adisoman/syklops-nova/README.md

# syklops-nova
Syklops nova is a series of beginner friendly I2C extender boards for GPIOs. It makes complex multi-component work possible, even for MCUs with fewer GPIOs.
