adisoman/syklops-nova/syklops1.kicad_pcb

## KiCad design syklops1.kicad_pcb (2026-01-10)

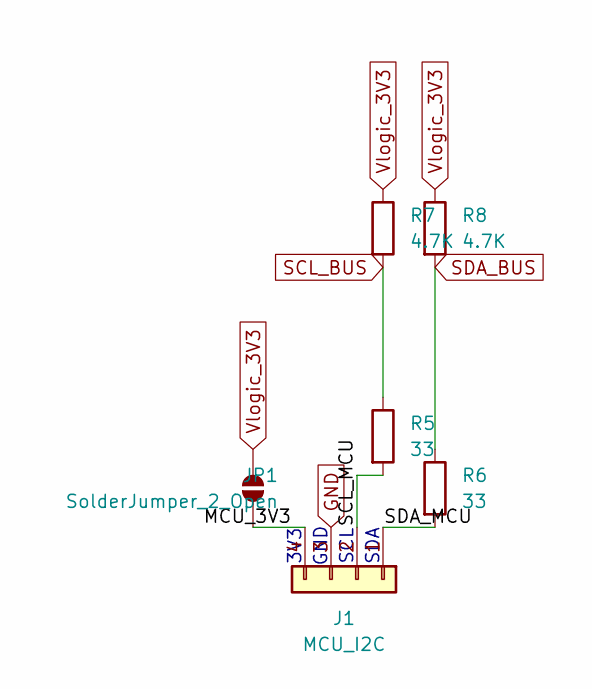
[picture p1: schematic mcu_interface.kicad_sch]

Parts:
J1: MCU_I2C; PinSocket_1x04_P2.54mm_Vertical; LCSC C5116530
JP1: SolderJumper_2_Open; SolderJumper-2_P1.3mm_Open_RoundedPad1.0x1.5mm
R5, R6: 33; R_0805_2012Metric; LCSC C17634
R7, R8: 4.7K; R_0805_2012Metric; LCSC C17673

Connections:
/MCU_interface/MCU_3V3: J1.4, JP1.1 (A)
/MCU_interface/SCL_MCU: J1.2, R5.2
/MCU_interface/SDA_MCU: J1.1, R6.2
GND: J1.3; also elsewhere on the board
SCL_BUS: R5.1, R7.2; also elsewhere on the board
SDA_BUS: R6.1, R8.2; also elsewhere on the board
Vlogic_3V3: JP1.2 (B), R7.1, R8.1; also elsewhere on the board

Notes on the sheet:
SDA
SCL
3V3
GND

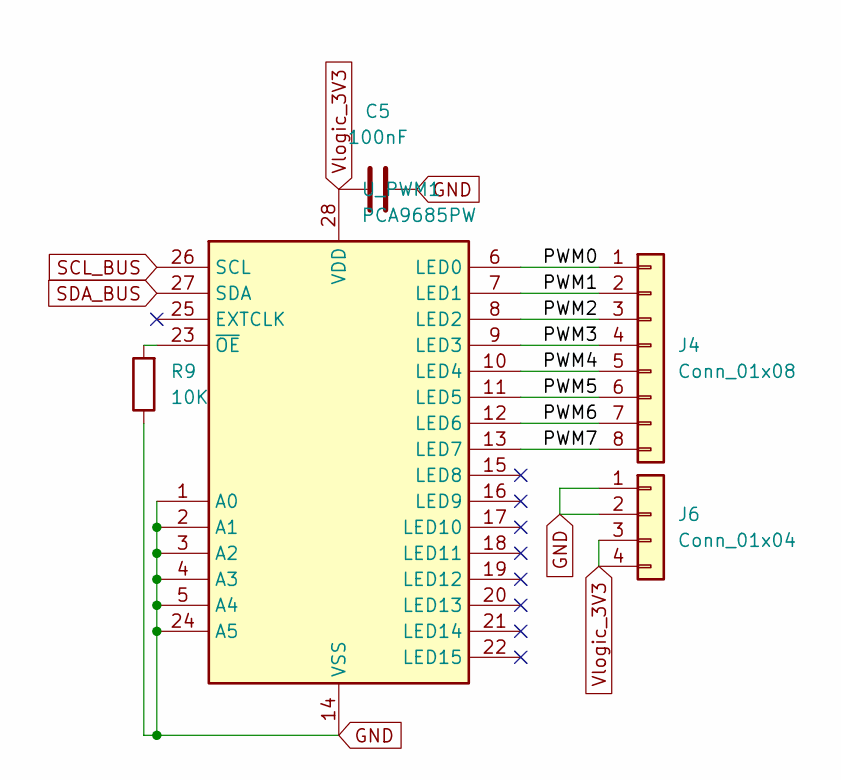
[picture p2: schematic pwm.kicad_sch]

Parts:
C5: 100nF; C_0805_2012Metric; LCSC C49678
J4: Conn_01x08; PinSocket_1x08_P2.54mm_Vertical; LCSC C18078131
J6: Conn_01x04; PinSocket_1x04_P2.54mm_Vertical; LCSC C5116530
R9: 10K; R_0805_2012Metric; LCSC C17414
U_PWM1: PCA9685PW; TSSOP-28_4.4x9.7mm_P0.65mm; LCSC C11628

Connections:
/PWM/PWM0: J4.1, U_PWM1.6 (LED0)
/PWM/PWM1: J4.2, U_PWM1.7 (LED1)
/PWM/PWM2: J4.3, U_PWM1.8 (LED2)
/PWM/PWM3: J4.4, U_PWM1.9 (LED3)
/PWM/PWM4: J4.5, U_PWM1.10 (LED4)
/PWM/PWM5: J4.6, U_PWM1.11 (LED5)
/PWM/PWM6: J4.7, U_PWM1.12 (LED6)
/PWM/PWM7: J4.8, U_PWM1.13 (LED7)
GND: C5.2, J6.1, J6.2, R9.1, U_PWM1.1 (A0), U_PWM1.2 (A1), U_PWM1.3 (A2), U_PWM1.4 (A3), U_PWM1.5 (A4), U_PWM1.14 (VSS), U_PWM1.24 (A5); also elsewhere on the board
unnamed: R9.2, U_PWM1.23 (~OE)
SCL_BUS: U_PWM1.26 (SCL); also elsewhere on the board
SDA_BUS: U_PWM1.27 (SDA); also elsewhere on the board
Vlogic_3V3: C5.1, J6.3, J6.4, U_PWM1.28 (VDD); also elsewhere on the board

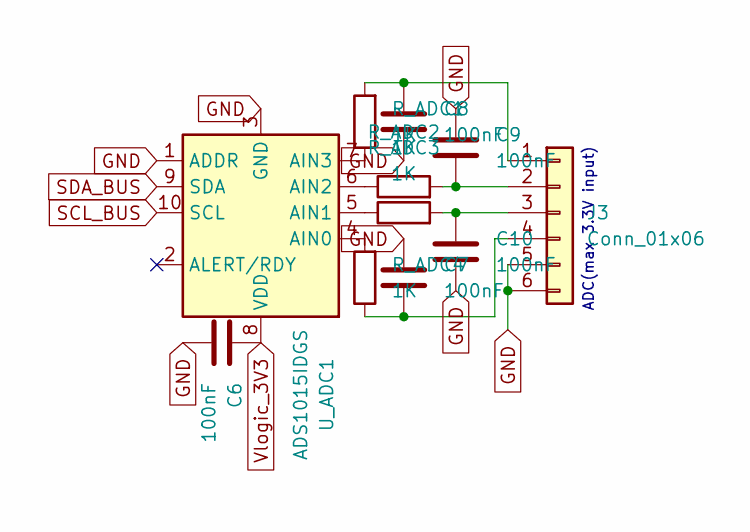
[picture p3: schematic adc_controller.kicad_sch]

Parts:
C6, C7, C8, C9, C10: 100nF; C_0805_2012Metric; LCSC C49678
J3: Conn_01x06; PinSocket_1x06_P2.54mm_Vertical; LCSC C40877
R_ADC1, R_ADC2, R_ADC3, R_ADC4: 1K; R_0805_2012Metric; LCSC C17513
U_ADC1: ADS1015IDGS; TSSOP-10_3x3mm_P0.5mm; LCSC C16581

Connections:
GND: C6.2, C7.1, C8.2, C9.1, C10.2, J3.5, J3.6, U_ADC1.1 (ADDR), U_ADC1.3 (GND); also elsewhere on the board
unnamed: C8.1, J3.1, R_ADC1.2
unnamed: C9.2, J3.2, R_ADC2.2
unnamed: C10.1, J3.3, R_ADC3.2
unnamed: C7.2, J3.4, R_ADC4.1
unnamed: R_ADC4.2, U_ADC1.4 (AIN0)
unnamed: R_ADC3.1, U_ADC1.5 (AIN1)
unnamed: R_ADC2.1, U_ADC1.6 (AIN2)
unnamed: R_ADC1.1, U_ADC1.7 (AIN3)
SCL_BUS: U_ADC1.10 (SCL); also elsewhere on the board
SDA_BUS: U_ADC1.9 (SDA); also elsewhere on the board
Vlogic_3V3: C6.1, U_ADC1.8 (VDD); also elsewhere on the board

Notes on the sheet:
ADC(max 3.3V input)

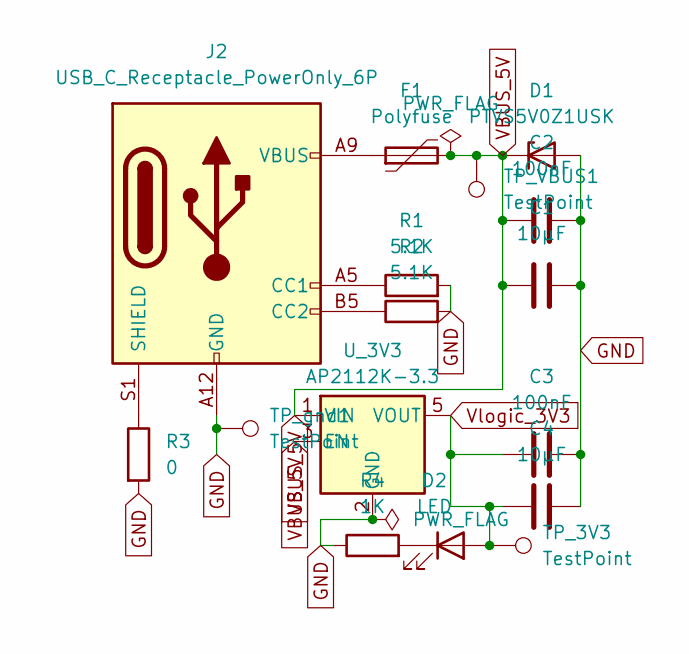
[picture p4: schematic power.kicad_sch]

Parts:
C1, C4: 10μF; C_0805_2012Metric; LCSC C15850
C2, C3: 100nF; C_0805_2012Metric; LCSC C49678
D1: PTVS5V0Z1USK; Nexperia_DSN1608-2_1.6x0.8mm; LCSC C85364
D2: LED; LED_0805_2012Metric; LCSC C2827270
F1: Polyfuse; Fuse_1206_3216Metric; LCSC C70059
J2: USB_C_Receptacle_PowerOnly_6P; USB_C_Receptacle_HRO_TYPE-C-31-M-17; LCSC C283540
R1, R2: 5.1K; R_0603_1608Metric; LCSC C23186
R3: 0; R_0805_2012Metric; LCSC C17477
R4: 1K; R_0805_2012Metric; LCSC C17604
TP_3V3: TestPoint; TestPoint_Pad_D1.5mm
TP_VBUS1: TestPoint; TestPoint_Pad_D1.5mm
TP_gnd1: TestPoint; TestPoint_Pad_D1.5mm
U_3V3: AP2112K-3.3; SOT-23-5; LCSC C51118

Connections:
GND: C1.2, C2.2, C3.2, C4.2, D1.2 (A), J2.A12 (GND), J2.B12 (GND), R1.2, R2.2, R3.2, R4.1, TP_gnd1.1, U_3V3.2 (GND); also elsewhere on the board
unnamed: D2.1 (K), R4.2
unnamed: F1.1, J2.A9 (VBUS), J2.B9 (VBUS)
unnamed: J2.A5 (CC1), R1.1
unnamed: J2.B5 (CC2), R2.1
unnamed: J2.S1 (SHIELD), R3.1
VBUS_5V: C1.1, C2.1, D1.1 (K), F1.2, TP_VBUS1.1, U_3V3.1 (VIN), U_3V3.3 (EN)
Vlogic_3V3: C3.1, C4.1, D2.2 (A), TP_3V3.1, U_3V3.5 (VOUT); also elsewhere on the board

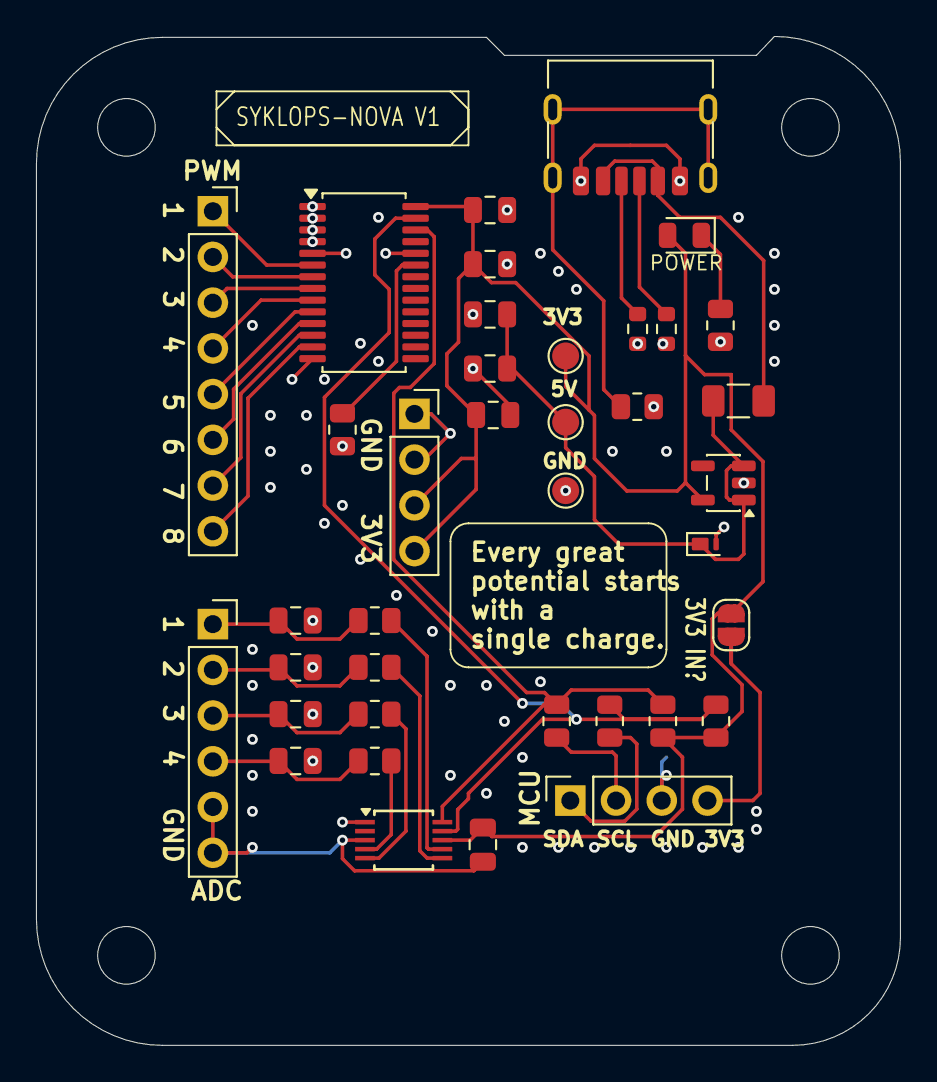
[picture p5: board syklops1.kicad_pcb from above]

Board: 2 copper layers, 48.0 x 56.1 mm, 38 parts (0 on the bottom side), 30 nets.
