adisoman/syklops-nova/(commit log)

2026-01-08 Add files via upload
    V1 : initial schematic with ADC expansion
    [adc_controller.kicad_sch, mcu_interface.kicad_sch, power.kicad_sch, pwm.kicad_sch, syklops1.kicad_pcb, syklops1.kicad_sch]
2026-01-08 Add files via upload
    v1.2 : complete schematics with added footprints, PCB layout remaining
    [adc_controller.kicad_sch, mcu_interface.kicad_sch, power.kicad_sch, pwm.kicad_sch]
2026-01-09 Add files via upload
    v3 : all components added to PCB editor. no mounting holes yet.
    [syklops1.kicad_pcb]
2026-01-09 Add files via upload
    v3 : almost complete PCB layout, one common GND instance missing, USB-C footprint without BOM
    [adc_controller.kicad_sch, power.kicad_sch, syklops1.kicad_pcb]
2026-01-10 Add files via upload
    V4 : completed and working PCB. now zero DRC errors yet. room for refinement but working.
    [power.kicad_sch, syklops1.kicad_pcb]
2026-01-10 Add files via upload
    V4 : full and final v1.1. Working schematics. Working PCB layout, zero ERC and DRC errors and warnings(except for cosmetic ones).
    [power.kicad_sch, syklops1.kicad_pcb]
2026-01-10 Add files via upload
    V5 : complete finish for v1, directly to-the-fab design.
    [adc_controller.kicad_sch, mcu_interface.kicad_sch, power.kicad_sch, pwm.kicad_sch, syklops1.kicad_pcb]
